rcalv002/rackmate/rackmate-teg-s380/output/rackmate_t1_teg_s380_shelf_full.step

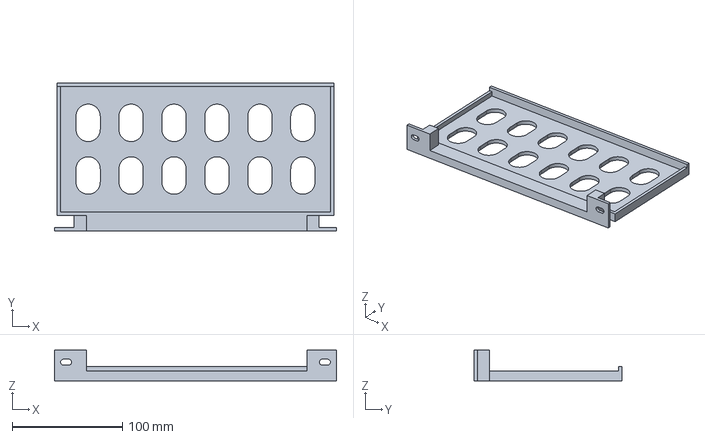
[picture p1: CAD file, 2026-07-08]
rackmate-teg-s380/output/rackmate_t1_teg_s380_shelf_full.step
255.9 x 134.4 x 28.0 mm
