rcalv002/rackmate/rackmate-teg-s380/output/rackmate_t1_mount_test_coupon.step

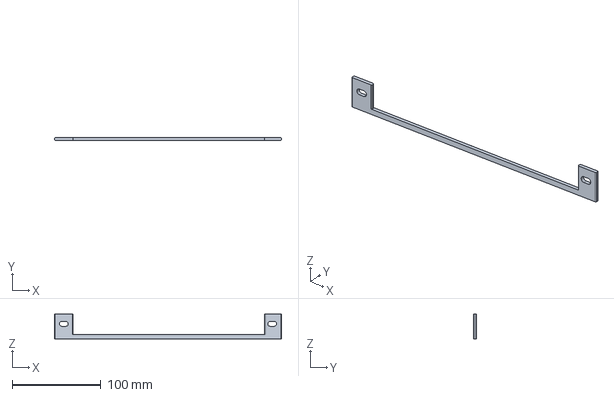
[picture p2: CAD file, 2026-07-08]
rackmate-teg-s380/output/rackmate_t1_mount_test_coupon.step
255.9 x 3.20 x 28.0 mm
