rcalv002/rackmate/rackmate-teg-s380/output/rackmate_t1_teg_s380_shelf_left.step

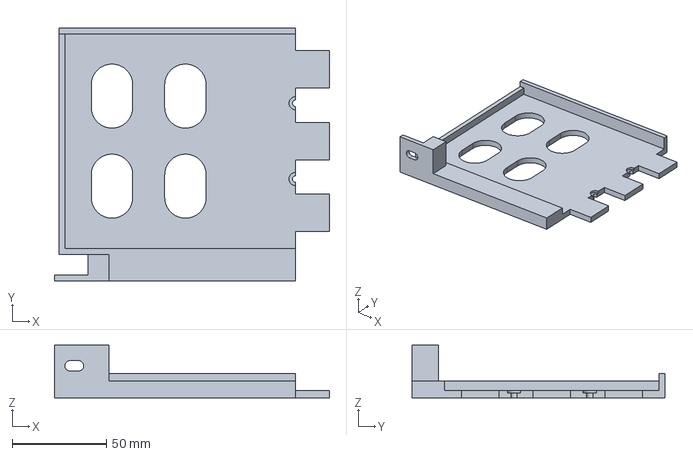
[picture p3: CAD file, 2026-07-08]
rackmate-teg-s380/output/rackmate_t1_teg_s380_shelf_left.step
146.0 x 134.4 x 28.0 mm
