rcalv002/rackmate/rackmate-teg-s380/output/rackmate_t1_teg_s380_shelf_right.step

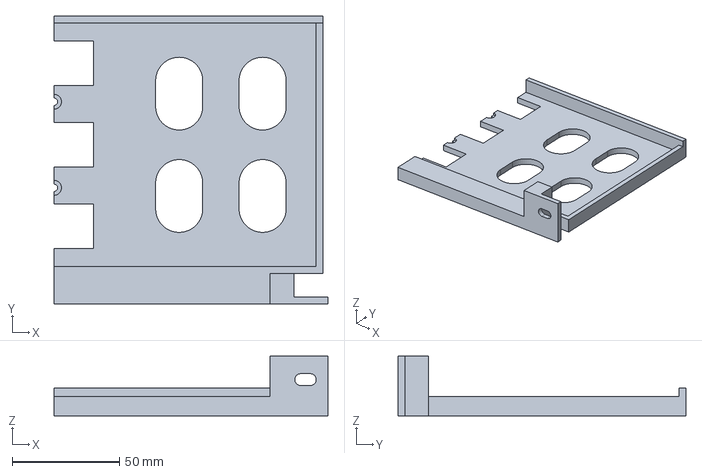
[picture p4: CAD file, 2026-07-08]
rackmate-teg-s380/output/rackmate_t1_teg_s380_shelf_right.step
128.0 x 134.4 x 28.0 mm
