rcalv002/rackmate/rackmate-teg-s380/output/rackmate_t1_front_fit_coupon.step

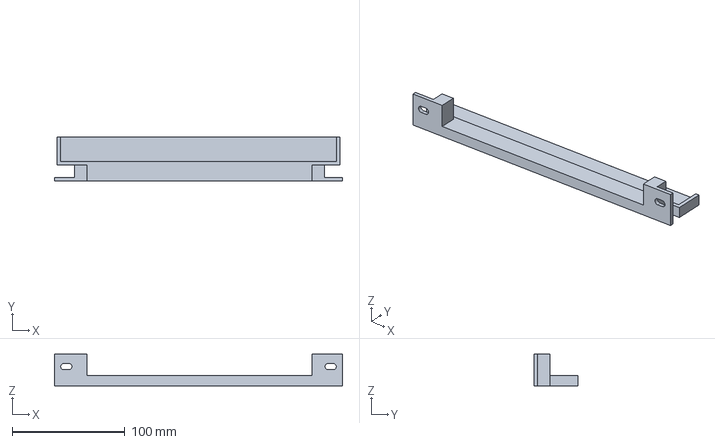
[picture p5: CAD file, 2026-07-08]
rackmate-teg-s380/output/rackmate_t1_front_fit_coupon.step
255.9 x 39.2 x 28.0 mm
