rcalv002/rackmate/(list of files, cad)

Other CAD files:
rackmate-teg-s380/output/rackmate_t1_front_fit_coupon.stl
rackmate-teg-s380/output/rackmate_t1_mount_test_coupon.stl
rackmate-teg-s380/output/rackmate_t1_teg_s380_shelf_full.stl
rackmate-teg-s380/output/rackmate_t1_teg_s380_shelf_left.stl
rackmate-teg-s380/output/rackmate_t1_teg_s380_shelf_right.stl
