rcalv002/rackmate/(commit log)

2026-07-05 update rail depth
    [rackmate_t1_mount_test_coupon.step, rackmate_t1_teg_s380_shelf_full.step, rackmate_t1_teg_s380_shelf_full.stl, rackmate_t1_teg_s380_shelf_left.step, rackmate_t1_teg_s380_shelf_left.stl, rackmate_t1_teg_s380_shelf_right.step, rackmate_t1_teg_s380_shelf_right.stl]
2026-07-05 add more surface area for front earloabs and make rail pocket deeper
    [rackmate_t1_mount_test_coupon.step, rackmate_t1_teg_s380_shelf_full.step, rackmate_t1_teg_s380_shelf_full.stl, rackmate_t1_teg_s380_shelf_left.step, rackmate_t1_teg_s380_shelf_left.stl, rackmate_t1_teg_s380_shelf_right.step, rackmate_t1_teg_s380_shelf_right.stl]
2026-07-05 include front face stub to save on poc printing
    [rackmate_t1_front_fit_coupon.step, rackmate_t1_front_fit_coupon.stl, rackmate_t1_mount_test_coupon.step, rackmate_t1_teg_s380_shelf_full.step, rackmate_t1_teg_s380_shelf_left.step, rackmate_t1_teg_s380_shelf_right.step]
2026-07-08 final adjustment kinda sorta maybe
    [rackmate_t1_front_fit_coupon.step, rackmate_t1_front_fit_coupon.stl, rackmate_t1_mount_test_coupon.step, rackmate_t1_mount_test_coupon.stl, rackmate_t1_teg_s380_shelf_full.step, rackmate_t1_teg_s380_shelf_full.stl, rackmate_t1_teg_s380_shelf_left.step, rackmate_t1_teg_s380_shelf_left.stl]
